jakabo27/Gesture-Controlled-Volleyball-Scoreboard/README.md

# Gesture-Controlled Volleyball Scoreboard

A portable, battery-powered LED scoreboard I designed and built from scratch, and taught to keep score by watching the players. A **Raspberry Pi 4** runs a pose-estimation neural network on a wide-angle camera at the net. When a player holds a **T-pose**, their team gets a point. Hands on top of the head (the "surrender cobra") takes the point back. An **Arduino Mega** owns the score, drives 252 addressable LEDs, plays voice clips from an SD card, and keeps working with its physical buttons whether or not the Pi is running.








<p align="center">
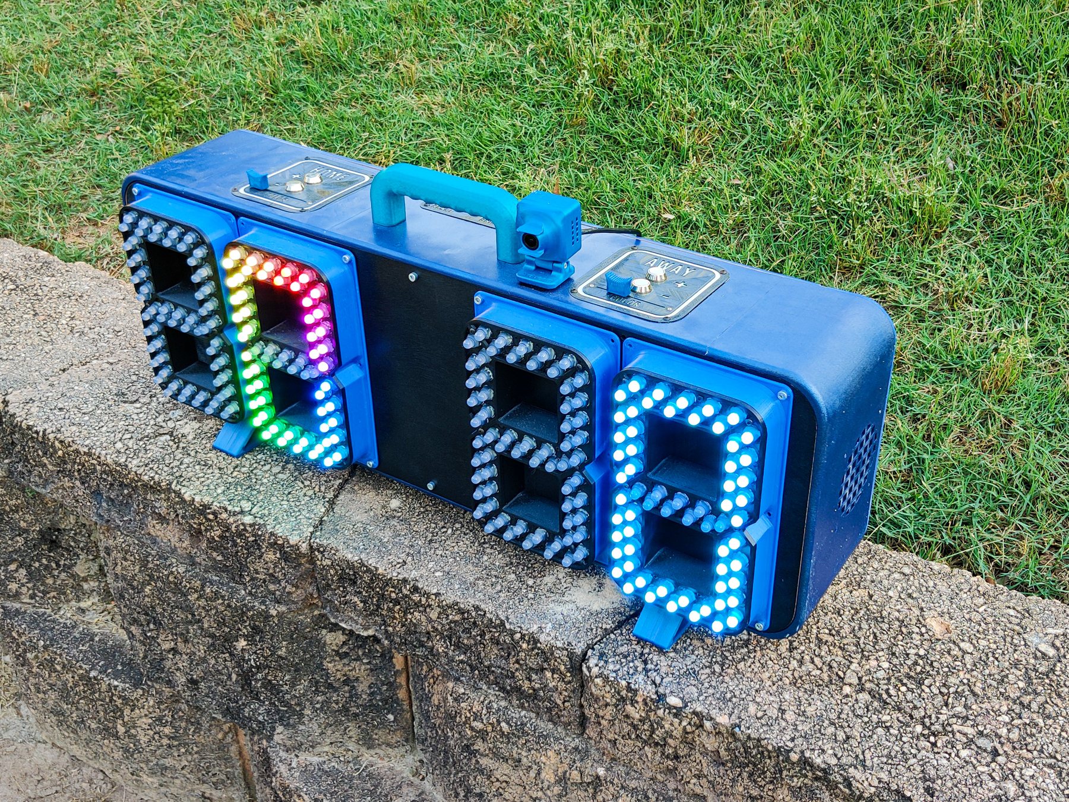
[picture p1: media/hardware/scoreboard-front.jpg]
The finished scoreboard sitting on a stone wall outdoors: a blue 3D-printed enclosure with a carry handle, four large seven-segment digits made of round LEDs (one lit in rainbow colors, one in blue), the camera on top, and the HOME and AWAY button panels on the top face
  
</p>

<!-- 🎬 HERO GIF: when media/video/tpose-scores-a-point.gif exists (see "Claude deleteme.md" → Shot list), uncomment the next line.
![A player holds a T-pose on the left side of the court; about half a second later the scoreboard's home score goes up by one and it announces the point](media/video/tpose-scores-a-point.gif)
-->

## Engineering skills on display

| Domain | What I built |
|---|---|
| **Edge ML & computer vision** | MoveNet MultiPose (TFLite, float16) on a Pi 4 CPU at ~2.9 fps. Two overlapping half-frame passes to track up to 12 players with a 6-person model, rule-based gesture recognition in pixel space, a live-fitted lens keystone model |
| **Embedded firmware** | Arduino Mega 2560 (C++): score and game logic, FastLED driving 252 WS2812B LEDs, 8-bit WAV playback from SD (TMRpcm), analog slide pots, I²C LCD, multi-button chords for menus, a checksummed serial protocol with the Pi (hello-gated, de-duplicated) |
| **Electrical & power** | Ryobi 18V tool-battery power, fused distribution, high-current 5V buck rail for the LEDs, Pi and Arduino, panel voltage and current meters, 3.3V→5V logic interfacing, a dozen hand-wired GPIO and data runs |
| **Mechanical & CAD** | Full enclosure designed in Fusion 360 and 3D-printed: segment carriers, battery dock, camera mount, vents and fan duct, service door, handle |
| **Linux reliability** | systemd service with watchdogs, camera hot-plug recovery, power-cut-safe file writes, boot-time tuning, remote deploys with automatic rollback |
| **Testing with real data** | Field-capture logging of every scored point, offline replay of saved keypoints to tune the rules, false-positive regression on recorded games, fault injection, soak testing |

## How it works

<picture>
  <source media="(prefers-color-scheme: dark)" srcset="media/diagrams/architecture-dark.svg">
  How it fits together. A wide-angle USB camera streams MJPG frames to a Raspberry Pi 4. The Pi runs MoveNet MultiPose on two overlapping half-frames, applies the T-pose and cobra gesture rules, and recovers on its own from faults. It talks to an Arduino Mega 2560 over a serial link: a hello every se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
</picture>

The split is deliberate. **The Arduino is in charge.** It holds the score, and the five physical buttons always work. The Pi only *suggests* points, over a serial link: it says hello every second while vision is live, and sends checksummed +1 / −1 messages for the camera's left (away) or right (home) half. The Arduino acts on them only while the hellos keep coming, and it announces when the Pi connects or drops out. If the camera fails, the Pi crashes, or it's simply left at home, the scoreboard is still a scoreboard.

1. **Camera:** a wide-angle USB camera sits low at the net post, looking along the net so it sees both teams. Frames arrive as hardware MJPG at 1280×720, read by a threaded grabber that always hands over the newest frame.
2. **Two passes:** each frame is split into a left half (the away team) and a right half (home) that overlap by 12% around the net line, and each half goes through MoveNet MultiPose separately.
3. **Rules:** every detected player is checked for a T-pose or a cobra in true pixel geometry. A T-pose has to appear in 2 of the last 3 frames, and a cobra has to be held for 0.8s.
4. **Point:** the Pi sends a checksummed message naming the camera half, three times with one id. The Arduino applies it once, adds the point, re-draws the digits and plays the point sound.

## The build

| | |
|:---:|:---:|
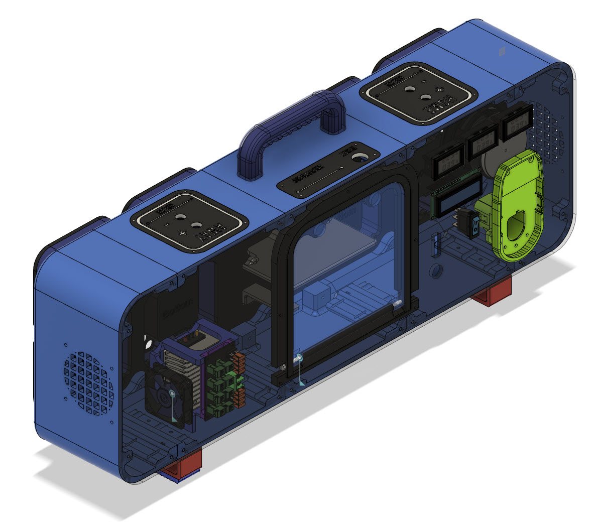
[picture p2: media/build/cad-render-fusion360.jpg]
Fusion 360 render of the enclosure with a transparent shell showing the Raspberry Pi, the battery dock and the internal layout
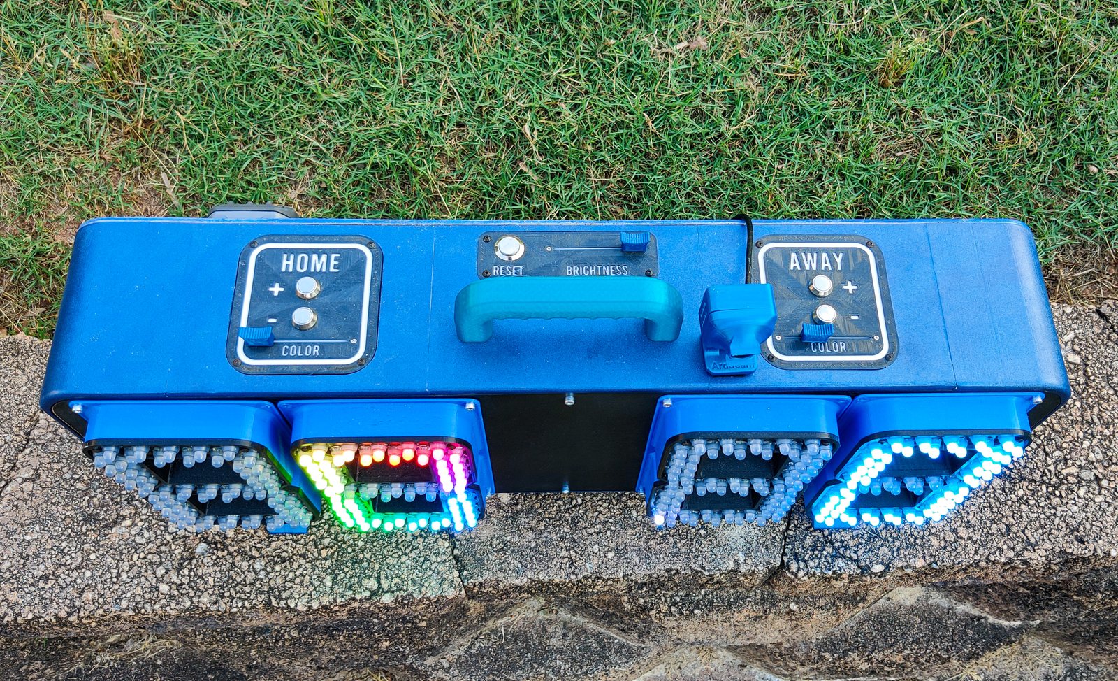
[picture p3: media/hardware/top-controls.jpg]
The top of the scoreboard: HOME and AWAY panels with plus, minus and color controls, the reset button and brightness slider in the middle, and the camera on its mount
|  |  |
| *Designed in Fusion 360 first: every internal part has a printed mount* | *Top controls: + / − per team, color sliders, reset and brightness* |
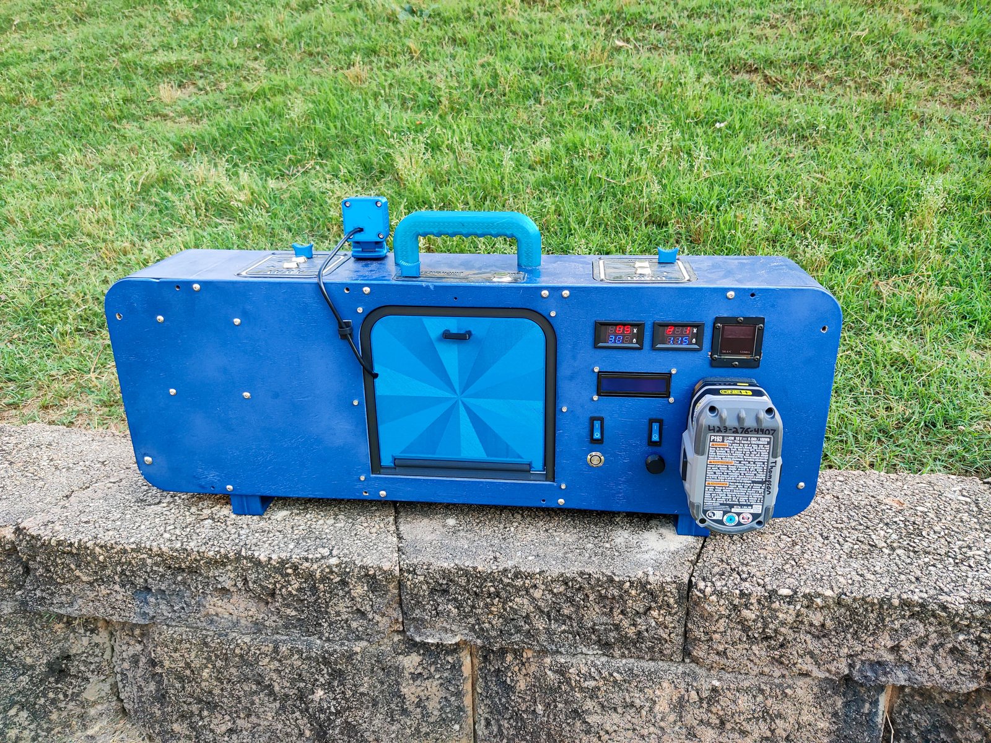
[picture p4: media/hardware/rear-panel.jpg]
The back of the scoreboard: a large speaker grille, two panel meters, the LCD, switches and the Ryobi 18V battery docked on the right
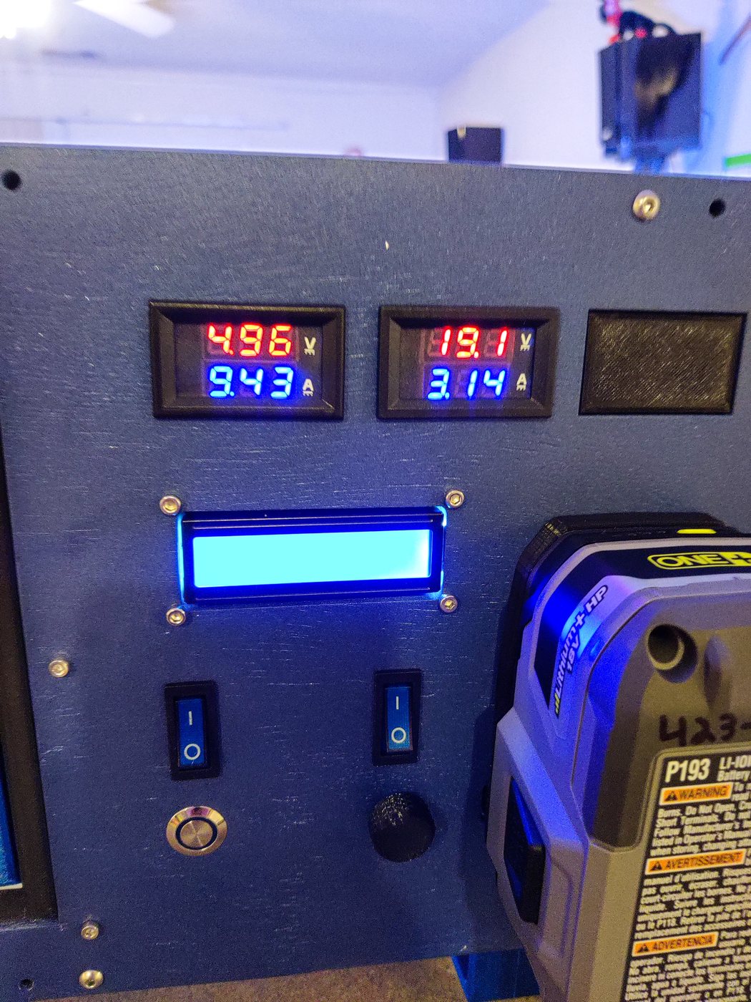
[picture p5: media/hardware/power-panel-closeup.jpg]
Close-up of the rear panel: two voltage and current meters reading 4.96V at 9.43A and 19.1V at 3.14A, a blue 16x2 LCD, two rocker switches, the power button and the Ryobi battery
|  |  |
| *Rear: speaker, power panel and a Ryobi 18V tool battery* | *Live meters for the 5V rail and the battery (here 9.4A at 5V with the LEDs lit)* |
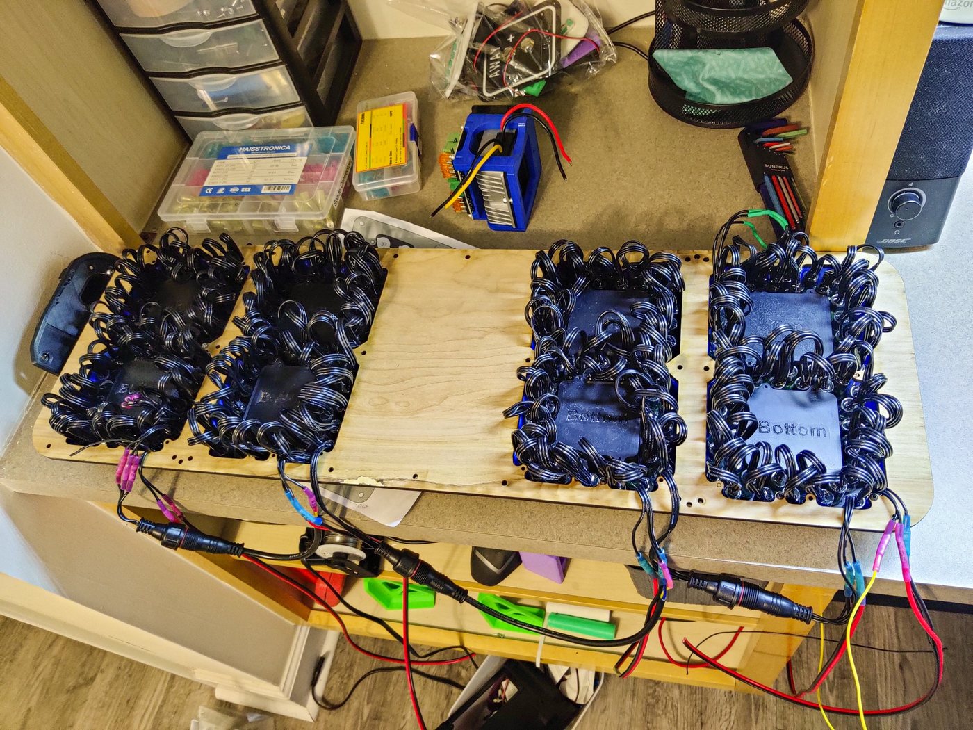
[picture p6: media/build/led-segment-build.jpg]
Four LED digit carriers on a workbench, each wound with strings of round WS2812B LEDs and wired to test leads
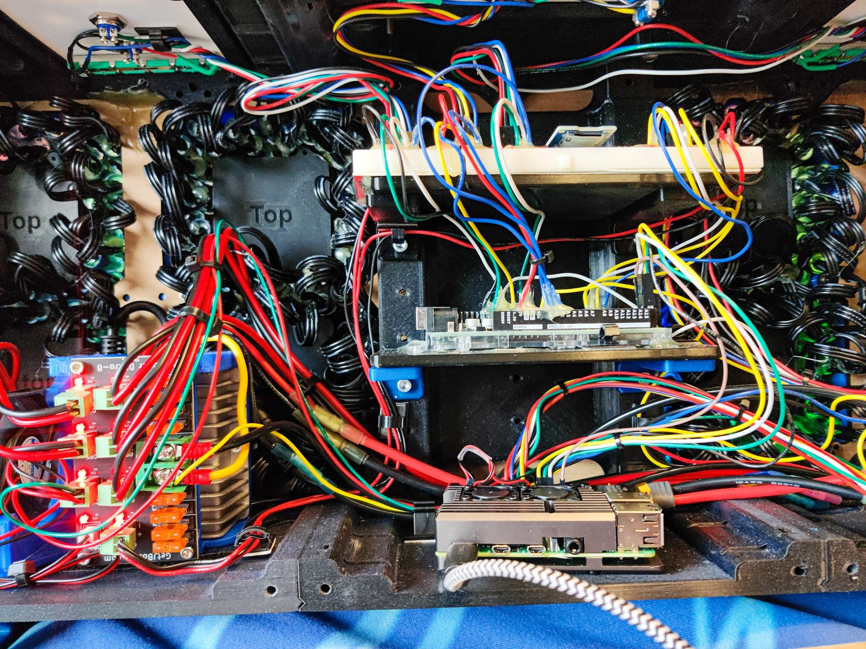
[picture p7: media/build/internal-wiring.jpg]
Inside the enclosure: the LED digit carriers on both sides, terminal blocks and distribution on the left, the Arduino Mega on a printed shelf, and the Raspberry Pi at the bottom
|  |  |
| *Each digit is 7 segments × 9 LEDs, strung by hand into printed carriers* | *Inside: power distribution (left), Arduino Mega (shelf) and the Pi (bottom)* |
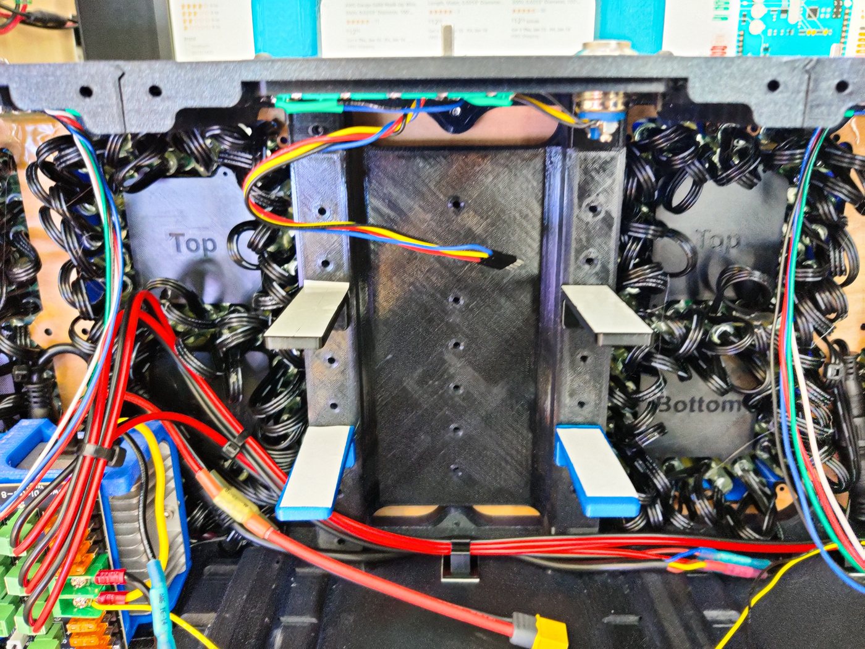
[picture p8: media/build/led-segment-wiring.jpg]
The back of the display during assembly: LED digit carriers labeled Top and Bottom, wired along a printed spine with data and power runs
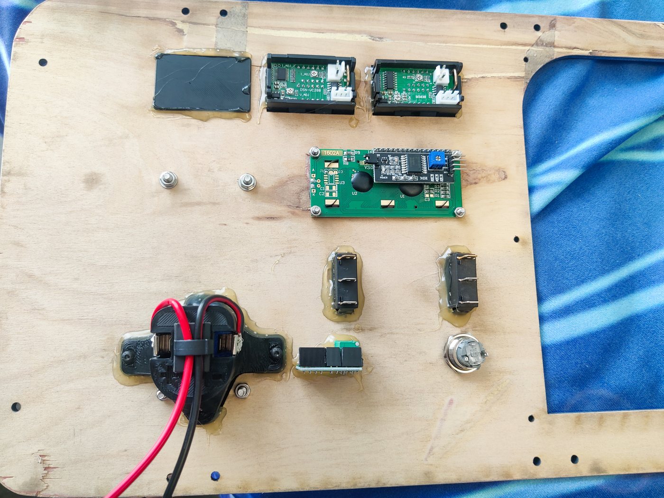
[picture p9: media/build/control-panel-prototype.jpg]
The rear control panel as a plywood prototype: two panel meters, the LCD, rocker switches, a power button and the battery connector, laid out before the final printed panel
|  |  |
| *Digit carriers going into the shell, data and power run along the spine* | *Rear panel laid out in plywood first, then printed* |
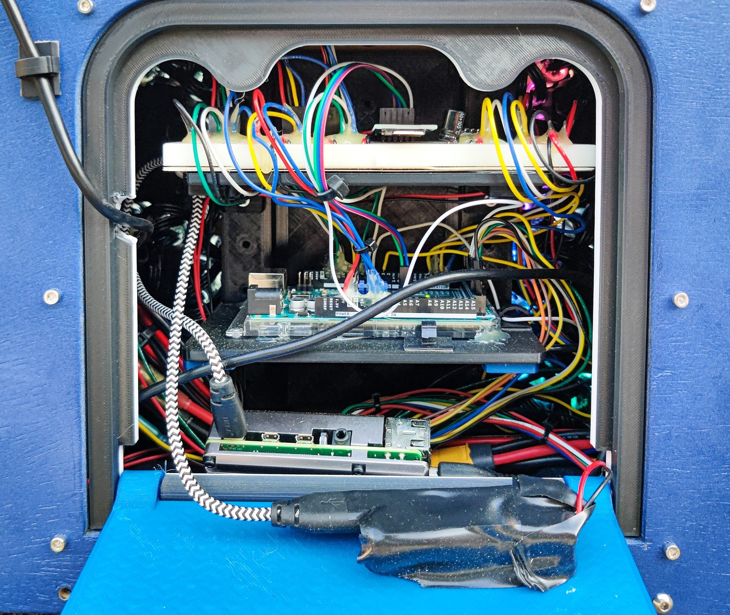
[picture p10: media/hardware/electronics-bay.jpg]
The electronics bay seen through the open service door: the Arduino Mega and wiring on a shelf above the Raspberry Pi
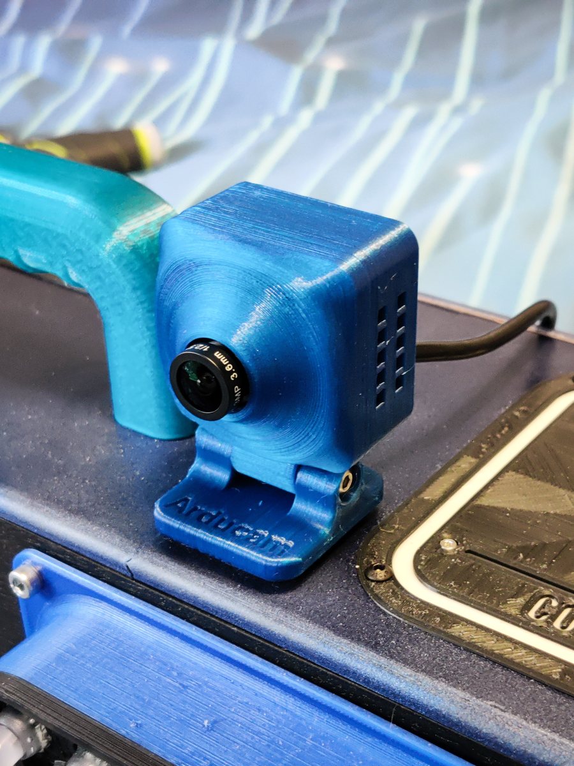
[picture p11: media/hardware/camera-mount.jpg]
The wide-angle USB camera in a blue 3D-printed housing on a hinged mount next to the handle
|  |  |
| *Service door open: everything stays reachable for repairs at the court* | *The camera in its printed, hinged housing* |

<!-- 📸 PHOTO SLOTS (see "Claude deleteme.md" → Shot list). Uncomment each row as the photo lands in media/.
| <img src="media/hardware/power-distribution.jpg" width="420" alt="The fuse block, 5V buck converter and XT60 battery input inside the enclosure"> | <img src="media/hardware/pi-arduino-harness.jpg" width="420" alt="The ribbon of GPIO wires between the Raspberry Pi header and the Arduino Mega's double-row header"> |
| *Power: battery input, fuses and the 5V buck converter* | *The Pi-to-Arduino signal harness* |
| <img src="media/hardware/oled-aim-assist.jpg" width="420" alt="The small OLED on the scoreboard showing the camera view with the yellow net line used to aim the camera"> | <img src="media/hardware/scoreboard-at-the-court.jpg" width="420" alt="The scoreboard set up at the net post during a game"> |
| *OLED aim assist: line the far net post up with the yellow line* | *At the court* |
-->

The enclosure is entirely 3D-printed. It has a carry handle, a hinged camera mount, vents and a cooling fan, a printed dock for a standard Ryobi 18V battery, and a service door. The power path runs from the battery through an XT60 connector and fuses to a high-current 5V buck converter. That one 5V rail feeds the LEDs (about 9.4A when bright), the Arduino and the Pi. Panel meters show the battery and the 5V rail live, which made checking the LED current budget easy in the field.

## What it does

- **Scores points from gestures:** T-pose for +1, the hands-on-head "surrender cobra" for −1 (to undo a mistake). Each team's side is decided by the player's **torso center**, so reaching over the net never scores for the other team.
- **Handles up to 12 players** (6v6) even though MoveNet MultiPose returns at most 6 people per image. [How →](#the-hard-parts)
- **Manual control always works:** + / − buttons per team, reset, brightness and per-team color sliders (including a rainbow mode). Button chords change settings: 2 buttons cycles game-to 21 / 25 / 15, 3 toggles voice or beeps, 4 switches between volleyball and **tennis scoring** (15 / 30 / 40, deuce and advantage spelled out on the 7-segment digits).
- **Talks:** voice clips for every point, undo, reset and mode change, a connect and disconnect announcement for the Pi, and a victory song when a team wins by 2.
- **Aims itself:** for the first 5 minutes after boot, a small OLED shows the camera view with the current net line, so the camera can be lined up with the far post.
- **Logs its own decisions:** every scored point saves the 20 frames before and 6 after with each player's skeleton and the exact rule values that passed or failed, so the rules can be tuned from real games.
- **Runs unattended:** it starts on power-up with no network, survives camera unplugs and power cuts, and shuts down cleanly from a held button.

## The hard parts

### 12 players from a 6-person model

MoveNet MultiPose returns at most **6 people** per image. A 6v6 game has 12 players, and a back-row player calling a point is exactly who a single pass drops. Each frame is split at the net line into two halves that **overlap by 12%**, and each half gets its own pass, so each team gets the model's full 6-person capacity. The overlap means an arm stretched across the net is never cropped off. Each pass then keeps only the people whose torso centroid is on its own side of the net line, so someone visible in both halves is checked exactly once, for the team they're standing with.

<p align="center">
  The camera view divided at the net line. The auto-calibrated net line is clamped to within 7% of center. A home player with their torso at x=0.41 reaches across the net line, and the point still goes to home.
</p>

The net line calibrates itself from the median positions of upright players on each side, smoothed over 30s windows, and is **hard-clamped to ±7%** of frame center so a timeout huddle on one side can't drag it away.

### A wide-angle camera sitting on the ground

The camera sits low and looks slightly up through a ~93° lens (measured with a checkerboard calibration). That breaks naive pose geometry in three ways, all found by replaying logged points frame by frame:

- **Keystone lean.** Upright people near the frame edges appear to lean outward, measured at about **−28° × (x − 0.5) + 2.4°**: roughly 10° at each edge. Real T-poses at the sideline failed the tilt check for 1.5s. A `KeystoneEstimator` re-fits that lean every 60s from upright people in view and subtracts it. It's only ever applied when it makes the check *more* lenient, so a bad fit can't block a real point.
- **Tilt-proof arm checks.** "Arms level" is measured along the player's own hip→shoulder axis instead of image vertical, and arms must be 90° ± 20° to the spine. That makes the check immune to a camera tilted on uneven sand.
- **Close players losing their heads.** Within ~2m of the camera, heads leave the frame and MoveNet mirrors left and right or loses a wrist. A T-pose is symmetric, so swapped labels are swapped back. One missing wrist is projected as a straight forearm from the elbow when the other arm is complete.

| | |
|:---:|:---:|
| The five T-pose rules: level arms within 0.35 shoulder widths, elbows at least 135 degrees, wingspan at least 1.85 shoulder widths, strict joint order, and held in 2 of the last 3 frames | Camera tilt on sand handled with spine-relative geometry, and wide-angle edge foreshortening handled by easing the wingspan requirement from 1.85 to 1.70 toward the frame edges |

**Result:** replaying 22 logged events, the new rules accepted **151 T-pose frames vs 80** before, losing none, and most points would have confirmed 2–3s sooner. Running the old and new rules on **392 recorded game frames** plus all indoor test footage, the new rules added 22 accepted frames and dropped none, and every added frame was a genuine T-pose.

**Drooping arms (Oct 5).** Real T-poses are often held with the arms a little below level. A second, relaxed tier accepts arms hanging up to 0.8 shoulder widths below the shoulders (never above level) but asks for a ~1 s hold instead of 2 of 3 frames. Replayed on the logged court frames it rescued a pose that had never scored, kept every point that scored before, and added no false positives. Details in [`docs/engineering-log.md`](docs/engineering-log.md) section 34.

<!-- 📸 DETECTION FRAME: a logged PoseEvent frame (skeleton, measured values, 2-of-3 window) belongs here. Candidates are in _private/candidate-media/.
<p align="center"><img src="media/screenshots/pose-event-trigger.jpg" width="720" alt="An annotated trigger frame: the player's skeleton drawn in green with the measured shoulder width, tilt, height offset, arm-to-spine angles and wingspan ratio, the yellow net line, and the 2-of-3 window state for each side"></p>
-->

### Running unattended on a battery at a beach

Nobody can SSH into it mid-game, so it has to recover from everything by itself:

- **Camera hot-plug.** The USB camera dropped off the bus several times during boot and once mid-game (USB `error -71`, with no undervoltage). The camera is now opened by its stable `/dev/v4l/by-id` path rather than `/dev/video0`, because it came back as `video1` and the old code kept retrying the wrong device. Bit-identical frames for 5s mean a hung camera, which gets re-opened. Frames older than 2s are refused, so a frozen image can never re-score. Verified with a software USB unbind and rebind: it recovers in about 12s.
- **Hello semantics.** A dedicated thread sends the serial hello every 1.0s, but only while the main loop is processing live frames, so "Pi connected" on the Arduino really means "vision is working".
- **Watchdogs.** If the main loop stops for 60s the process exits, and systemd restarts it. The camera thread catches any exception, releases the device and re-opens it.
- **Power cuts.** It gets switched off at the battery. Every capture is written to a `.tmp` file, `fsync`ed, then atomically renamed, and leftover temp files are cleaned at start-up. The Pi has no clock battery, so time jumps by hours once NTP syncs. All interval timing uses `time.monotonic()`, and capture files carry a session counter instead of trusting the wall clock.
- **Bounded everything.** There's a 5GB capture cap with oldest-first rotation (scored points are kept), a stop-writing threshold at 2GB free, and bounded queues. Memory stayed flat at about 203MB over long runs.
- **Boot.** Live detection starts about 14s after the kernel starts. The service no longer waits for the network, Bluetooth initialization is disabled, and cold imports are the remaining cost.

### An embedded bug worth remembering

The Arduino decides whether the Pi is alive by comparing heartbeat periods: `this < prev + range && this > prev - range`. An intermediate firmware made those periods `unsigned long`. With a 1s heartbeat and a 700ms range, `prev - range` is fine, but for any period under 700ms it **wraps to about 4.29 billion**, so no period ever matched. The Pi was declared disconnected about 7s after every connect. The fix is signed 32-bit `long` periods, plus a debounce of 3 consecutive irregular beats before declaring a disconnect, and an instant first connect on boot.

The heartbeat wire has since been retired altogether. While the Pi boots or shuts down it pulls GPIO 0–8 high for about 17s, and the Arduino counted the "home" line sitting high as a point every 3s. Rather than keep patching pulse timing, every Pi → Arduino signal now travels over the serial link that was added for the phone display: a hello is the heartbeat, and each gesture is a checksummed message sent three times with one id, so a copy lost while the LEDs refresh (interrupts off for ~8ms) doesn't matter and a duplicate is never counted twice.

## Measured

| | Result |
|---|---|
| Vision loop (two MoveNet passes + rules) | **~340ms per frame (~2.9 fps)** on a Pi 4, 3 inference threads |
| Hold-to-point latency | 2 of 3 frames ≈ **0.3–0.6s** once the pose is held |
| Players tracked | up to **12** (6 per half) |
| Boot to live detection | **~14s** after kernel start |
| Camera USB drop-out → frames again | **~12s**, automatic |
| Memory over a long run | flat at **~203MB** RSS |
| Rule rework on 22 logged events | **151 vs 80** accepted frames, 0 lost |
| False-positive check (392 game frames + indoor footage) | 0 accepted frames lost, 22 added, all genuine |

## Wiring

<p align="center">
  Wiring diagram: the serial link (Pi GPIO 0 and 1 to Mega pins 15 and 14, through a 1k resistor and a 5.1k/10k divider) carries every signal; the older GPIO wires (Pi GPIO 5, 6, 19, 21, 26 and 13 to Mega pins 45, 47, 43, 42, 46 and 44) are legacy; plus physical pin locator maps for both boards
</p>

| Signal | Pi pin (BCM) | Mega pin | Notes |
|---|---|---|---|
| **Serial: Pi → Arduino** (pink) | 27 (GPIO 0, TXD2) | 15 (RX3) | via 1k. Hello every 1s, gestures (+1 / −1), phone commands |
| **Serial: Arduino → Pi** (pink) | 28 (GPIO 1, RXD2) | 14 (TX3) | via a 5.1k/10k divider (the Mega TX is 5V). Score state for the phone |
| Ground | 39 | GND | common ground is mandatory |
| Home +1 (camera right), legacy | 29 (GPIO 5) | 45 | held low; only read for an older engine (hello version 1) |
| Away +1 (camera left), legacy | 31 (GPIO 6) | 47 | same |
| Away −1 (camera left), legacy | 35 (GPIO 19) | 43 | same |
| Home −1 (camera right), legacy | 40 (GPIO 21) | 42 | same; no signal reaches pin 42 (measured) |
| Heartbeat, legacy | 37 (GPIO 26) | 46 | ignored: the serial hello is the heartbeat |
| Spare | 33 (GPIO 13) | 44 | unused |

The GPIO wires stay connected but are no longer used. The pin pairs above are as measured on the bench in October 2026; the original wiring notes had each pair crossed.

The Pi's 3.3V outputs drive the Mega's 5V inputs directly: 3.3V clears the ATmega2560's 3.0V input-high threshold, and nothing ever drives 5V back into the Pi. Locally on the Pi there's also an SSD1351 RGB OLED on SPI and a power button (hold 5s to shut down). Full details are in [`pi/README.md`](pi/README.md) and [`arduino/README.md`](arduino/README.md). To set up a Pi from a blank SD card (including how everything starts on boot), see [`docs/pi-setup-from-scratch.md`](docs/pi-setup-from-scratch.md).

## The score on my phone

A phone page shows the live score in huge digits, runs the game clock, and has +1 / −1 buttons and settings, **over Bluetooth LE with no Wi-Fi** (there usually isn't any at the courts).

<p align="center">
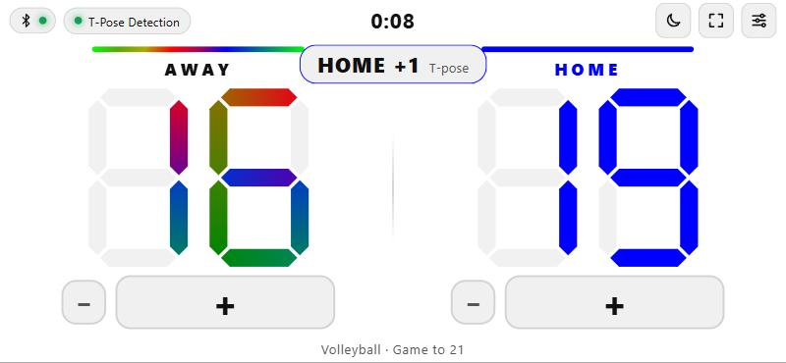
[picture p12: media/screenshots/phone-display-landscape.jpg]
The phone page in landscape: a Bluetooth status icon, a T-Pose Detection switch and a game clock along the top, away and home scores in large seven-segment digits in the team colors, and a large plus and a small minus button under each team
  
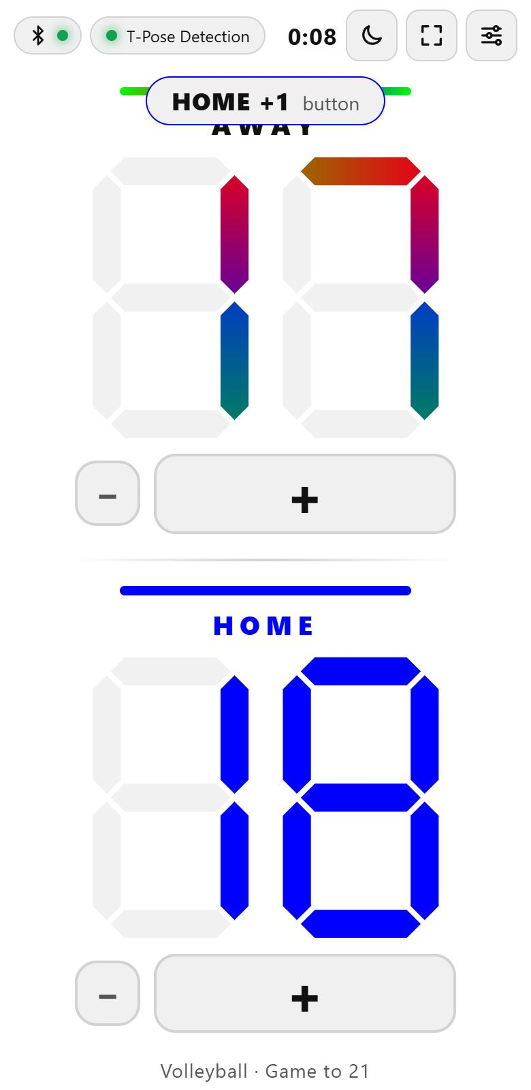
[picture p13: media/screenshots/phone-display-portrait.jpg]
The same page in portrait with the two teams stacked
  
</p>

* The **Arduino stays the source of truth** and only broadcasts its state over a one-way serial link (Mega TX3 → Pi UART2, through a 5.1k/10k divider), so the scoreboard works exactly as before with no Pi or phone.
* A small **Pi service** turns that into a Bluetooth LE GATT service (BlueZ over D-Bus) and forwards a whitelist of phone commands back: score +/−, sport, game-to, and the sound mode.
* The **page** is a dependency-free Web Bluetooth app on GitHub Pages, installable and cached for offline use. It copies the LED colors exactly (including the strip's swapped red/green), and a **T-Pose Detection** switch can turn off the Pi's gesture scoring from the phone if false positives show up in a game.
* Connections are manual, the Pi never pairs, and a phone must say "hello" within a few seconds or it's disconnected, so other Bluetooth apps in the stands can't take over the scoreboard.
* Android with Chrome is the reliable path. iPhones need the Bluefy app (Safari has no Web Bluetooth), and the Pi's Bluetooth stack was upgraded to BlueZ 5.79 to survive them.

Wiring, protocol, deployment and the lessons learned (like why the LEDs must not refresh while a sound clip plays) are in [`docs/phone-display.md`](docs/phone-display.md); the page's own notes are in [`web/`](web/).

## Repository layout

| Folder | What's in it |
|---|---|
| [`pi/`](pi/) | The vision engine as deployed: `PoseEstimationJT_Optimized.py`, the OLED helper, the TFLite model, the systemd unit and a `/boot/config.txt` snapshot |
| [`arduino/`](arduino/) | The Mega 2560 scoreboard firmware |
| [`legacy/`](legacy/) | The original 2022 Pi script, kept for comparison |
| [`web/`](web/) | The phone display: a Web Bluetooth page (live score, game clock, +/− buttons, settings, day and night themes) |
| [`tests/`](tests/) | Wire-contract tests that keep the Arduino line format, the Pi's BLE packet and the page's decoder in sync |
| [`docs/`](docs/) | The engineering log (every measurement and decision, in order) and the [phone display write-up](docs/phone-display.md) |
| [`tools/`](tools/) | `clean_wavs.py` (de-hiss, trim and normalize the SD-card voice clips) and the source for the architecture diagram |
| `media/` | Photos, diagrams, screenshots |

## History

Version 1 was built over the 2021–22 winter: the enclosure, the LED digits, the Arduino firmware, and a first Pi script that checked the left half of the court, then the right half only if the left had no T-pose (one MoveNet pass each, so at most 6 people per side, and no recovery from crashes). In 2026 I rebuilt the vision side for real games: 12-player coverage, the wide-angle geometry fixes, the reliability work, field logging and boot tuning. The 2022 script is in [`legacy/`](legacy/) for comparison.

## License

MIT. See [`LICENSE`](LICENSE). The MoveNet model is Apache 2.0 (see [`pi/README.md`](pi/README.md)).
