jakabo27/Gesture-Controlled-Volleyball-Scoreboard/tests/fixtures/pole_early.jpg

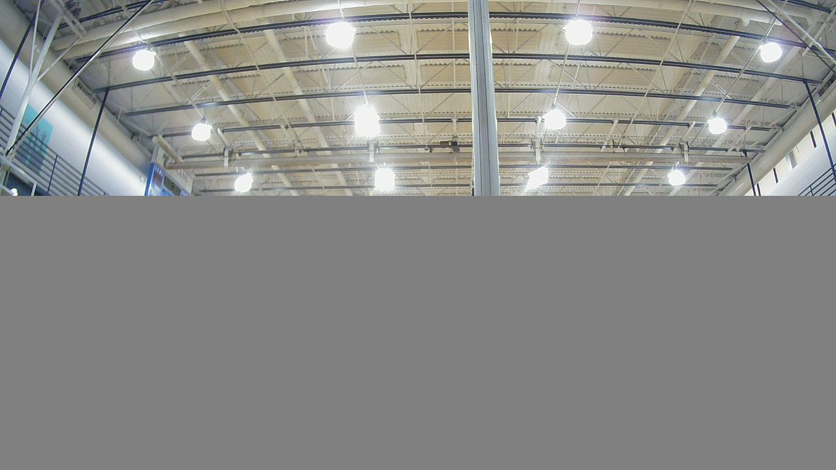
tests/fixtures/pole_early.jpg
