jakabo27/Gesture-Controlled-Volleyball-Scoreboard/tests/fixtures/pole_late.jpg

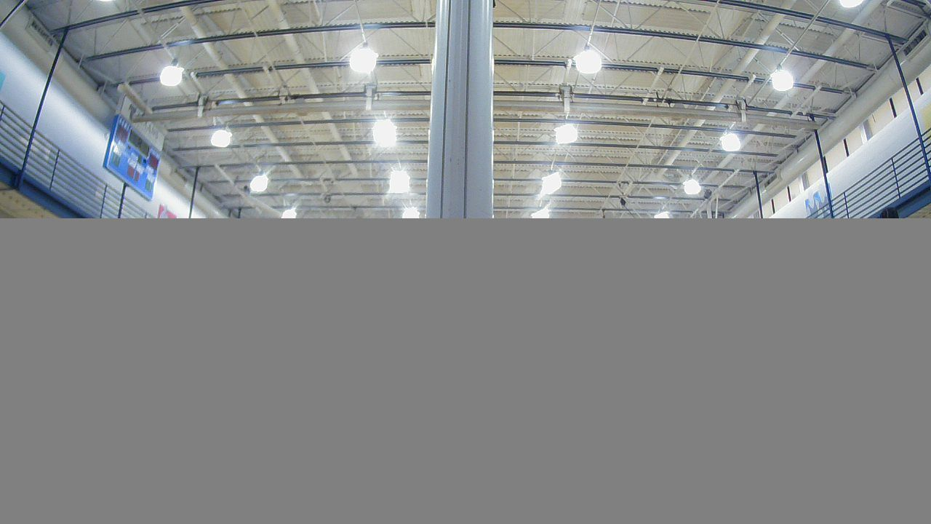
tests/fixtures/pole_late.jpg
