jakabo27/Gesture-Controlled-Volleyball-Scoreboard/tests/test_tpose_rules.py

"""
Rule tests for the T-pose check and its two-tier confirmation in pi/PoseEstimationJT_Optimized.py. Needs numpy.
Run from the repo root:

    python tests/test_tpose_rules.py

The engine imports the camera, TFLite and GPIO libraries, so the functions under test are pulled out of its source
with ast and run in a small namespace (same idea as the sketch checks in test_link_protocol.py).

The skeletons are synthetic: shoulders 80 px apart, arms 120 px long (1.5 shoulder widths), hanging `drop_deg` below
level (negative = raised). Numbers below were checked against real court frames in docs/engineering-log.md section 34.
"""
import ast
import math
import os
import sys
import unittest

import numpy as np

ROOT = os.path.dirname(os.path.dirname(os.path.abspath(__file__)))
ENGINE = os.path.join(ROOT, 'pi', 'PoseEstimationJT_Optimized.py')

NEEDED_FUNCS = {'calculate_angle_px', 'check_t_pose', 'tpose_confirmed', 'people_present', 'read_strictness'}
NEEDED_CONSTS = {'LIMB_CONF_THRESH', 'CLOSE_RANGE_SHOULDER_PX', 'CLOSE_RANGE_TOP_FRACTION', 'MIN_TPOSE_SHOULDER_PX', 'KP',
                 'POSE_HOLD_FRAMES', 'POSE_WINDOW_FRAMES', 'STRICTNESS_FILE', 'DEFAULT_STRICTNESS', 'STRICTNESS_PRESETS',
                 'STRICTNESS_WINDOW_MAX', 'SAVE_MIN_SHOULDER_PX', '_strictness_cache'}


def load_engine():
    src = open(ENGINE, encoding='utf-8').read()
    chunks = []
    for node in ast.parse(src).body:
        if isinstance(node, ast.FunctionDef) and node.name in NEEDED_FUNCS:
            chunks.append(ast.get_source_segment(src, node))
        elif isinstance(node, ast.Assign) and any(isinstance(t, ast.Name) and t.id in NEEDED_CONSTS for t in node.targets):
            chunks.append(ast.get_source_segment(src, node))
    ns = {'np': np, 'os': os}
    exec('\n\n'.join(chunks), ns)
    return ns


E = load_engine()
KP = E['KP']
FRAME_H = 648


def person(drop_deg=0.0, elbow_bend_deg=0.0, shoulder_w=80.0, arm_len=120.0, cx=640.0, conf=0.9):
    """Front-facing person, arms out to the sides, hanging drop_deg below level (negative = raised)."""
    k = np.zeros((17, 3), dtype=np.float32)
    k[:, 2] = conf
    half = shoulder_w / 2.0
    sy, hy = 300.0, 420.0
    k[KP['left_shoulder']][:2] = (cx + half, sy)          # the person's left = image right (no label swap needed)
    k[KP['right_shoulder']][:2] = (cx - half, sy)
    k[KP['left_hip']][:2] = (cx + half * 0.7, hy)
    k[KP['right_hip']][:2] = (cx - half * 0.7, hy)
    t = math.radians(drop_deg)
    bend = math.radians(elbow_bend_deg)
    for side, sh_name, el_name, wr_name in ((1.0, 'left_shoulder', 'left_elbow', 'left_wrist'),
                                            (-1.0, 'right_shoulder', 'right_elbow', 'right_wrist')):
        sx, sy_ = k[KP[sh_name]][:2]
        ex, ey = sx + side * 0.55 * arm_len * math.cos(t), sy_ + 0.55 * arm_len * math.sin(t)
        k[KP[el_name]][:2] = (ex, ey)
        # forearm continues the upper arm, optionally bent upwards by elbow_bend_deg
        ft = t - bend
        k[KP[wr_name]][:2] = (ex + side * 0.45 * arm_len * math.cos(ft), ey + 0.45 * arm_len * math.sin(ft))
    return k


def check(k, preset=None):
    diag = {}
    limits = E['STRICTNESS_PRESETS'][preset] if preset is not None else None     # None = the default (Standard)
    ok = E['check_t_pose'](k, player_global_x=0.5, expected_lean_deg=0.0, frame_h=FRAME_H, diag=diag, limits=limits)
    return ok, diag['fails'], diag['metrics']


class TPoseRuleTest(unittest.TestCase):
    def test_level_arms_pass_the_strict_tier(self):
        ok, fails, m = check(person(0))
        self.assertTrue(ok, fails)
        self.assertFalse(m['relaxed_only'])

    def test_slightly_raised_arms_still_pass_strict(self):
        ok, fails, m = check(person(-10))
        self.assertTrue(ok, fails)
        self.assertFalse(m['relaxed_only'])

    def test_drooping_arms_pass_only_the_relaxed_tier(self):
        for drop in (15, 25):
            ok, fails, m = check(person(drop))
            self.assertTrue(ok, 'droop %d: %s' % (drop, fails))
            self.assertTrue(m['relaxed_only'], 'droop %d should need the longer hold' % drop)

    def test_arms_hanging_far_below_level_fail(self):
        ok, fails, _ = check(person(40))
        self.assertFalse(ok)
        self.assertIn('height_align', fails)

    def test_raised_arms_are_not_relaxed(self):
        # the relaxation is one-sided: hanging low is tolerated, rising above level is not
        for rise in (-15, -25):
            ok, fails, _ = check(person(rise))
            self.assertFalse(ok, 'arms %d deg above level must still fail' % -rise)
            self.assertIn('height_align', fails)

    def test_bent_elbows_fail(self):
        ok, fails, _ = check(person(0, elbow_bend_deg=70))
        self.assertFalse(ok)
        self.assertIn('elbow_straight', fails)

    def test_arms_down_fail(self):
        ok, _, _ = check(person(80))
        self.assertFalse(ok)

    def test_far_player_tolerance_floor(self):
        # small player (40 px shoulders): the 14 px floor applies, a clean T-pose still passes
        ok, fails, _ = check(person(0, shoulder_w=40.0, arm_len=60.0))
        self.assertTrue(ok, fails)


class StrictnessPresetTest(unittest.TestCase):
    """The phone's Detection strictness: 0 Stricter, 1 Standard (default), 2 Looser, 3 Loosest. Each step lets arms hang a
    little lower, down to about 45 degrees away from the side of the body for Loosest; arms ABOVE level are never relaxed.
    (Skeleton: shoulders 80 px, arms 120 px, so the allowed drop is 0.65 / 0.8 / 0.9 / 1.0 shoulder widths = 52 / 64 / 72 /
    80 px against 120 * sin(drop_deg); the spine angle limits are 125 / 130 / 130 / 135 deg = 35 / 40 / 40 / 45 deg below level.)"""

    def passes(self, drop, preset):
        return check(person(drop), preset)[0]

    def test_four_presets_in_order(self):
        names = [p['name'] for p in E['STRICTNESS_PRESETS']]
        self.assertEqual(names, ['Stricter', 'Standard', 'Looser', 'Loosest'])
        self.assertEqual(E['DEFAULT_STRICTNESS'], 1)
        below = [p['below_k'] for p in E['STRICTNESS_PRESETS']]
        spine = [p['spine_max'] for p in E['STRICTNESS_PRESETS']]
        self.assertEqual(below, sorted(below))
        self.assertEqual(spine, sorted(spine))

    def test_default_limits_are_standard(self):
        for drop in (0, 15, 30, 35, 40, 55):
            self.assertEqual(check(person(drop))[0], check(person(drop), 1)[0], drop)

    def test_each_step_accepts_lower_arms(self):
        expect = {                 # drop_deg: (stricter, standard, looser, loosest)
            15: (True, True, True, True),
            30: (False, True, True, True),
            35: (False, False, True, True),
            40: (False, False, False, True),
            45: (False, False, False, False),    # 120 * sin(45) = 85 px > the loosest 80 px drop: just past the loosest limit
            60: (False, False, False, False),
        }
        for drop, row in expect.items():
            self.assertEqual(tuple(self.passes(drop, i) for i in range(4)), row, 'drop %d' % drop)

    def test_raised_arms_fail_at_every_strictness(self):
        for preset in range(4):
            for rise in (-15, -25, -40):
                self.assertFalse(check(person(rise), preset)[0], 'preset %d, arms %d deg above level' % (preset, -rise))

    def test_clean_t_pose_passes_everywhere_as_strict(self):
        for preset in range(4):
            ok, fails, m = check(person(0), preset)
            self.assertTrue(ok, fails)
            self.assertFalse(m['relaxed_only'])

    def test_every_preset_holds_the_same_3_of_4(self):
        for p in E['STRICTNESS_PRESETS']:
            self.assertEqual((p['hold'], p['window']), (3, 4), p['name'])
            self.assertFalse(E['tpose_confirmed']([0, 1, 1, 0], p['hold'], p['window']), p['name'])   # two relaxed frames
            self.assertTrue(E['tpose_confirmed']([0, 1, 1, 1], p['hold'], p['window']), p['name'])    # three of four
            self.assertTrue(E['tpose_confirmed']([1, 1, 0, 1], p['hold'], p['window']), p['name'])

    def test_history_is_long_enough_for_every_preset(self):
        self.assertEqual(E['STRICTNESS_WINDOW_MAX'], max(p['window'] for p in E['STRICTNESS_PRESETS']))


class StrictnessFileTest(unittest.TestCase):
    """read_strictness: the engine re-reads the phone's choice about once a second; anything odd means Standard."""

    def setUp(self):
        import tempfile
        self.dir = tempfile.mkdtemp()
        self.path = os.path.join(self.dir, 'strictness.txt')
        E['STRICTNESS_FILE'] = self.path
        E['_strictness_cache']['t'] = -1e9

    def read(self, now):
        return E['read_strictness'](now)

    def test_missing_file_is_standard(self):
        self.assertEqual(self.read(1000.0), E['DEFAULT_STRICTNESS'])

    def test_values_are_picked_up_after_a_second(self):
        for i, v in enumerate((0, 2, 3)):
            open(self.path, 'w').write('%d\n' % v)
            self.assertEqual(self.read(2000.0 + 10 * i), v)

    def test_cached_within_a_second(self):
        open(self.path, 'w').write('3\n')
        self.assertEqual(self.read(3000.0), 3)
        open(self.path, 'w').write('0\n')
        self.assertEqual(self.read(3000.5), 3)       # not re-read yet
        self.assertEqual(self.read(3001.5), 0)

    def test_junk_is_standard(self):
        for i, junk in enumerate(('', 'abc', '7', '-1', '1.5')):
            open(self.path, 'w').write(junk)
            self.assertEqual(self.read(4000.0 + 10 * i), E['DEFAULT_STRICTNESS'], repr(junk))


class ConfirmationTest(unittest.TestCase):
    """window values: 0 = no T-pose, 1 = relaxed-only pass, 2 = strict pass; newest last"""

    def test_strict_needs_two_of_the_last_three(self):
        c = E['tpose_confirmed']
        self.assertTrue(c([0, 2, 0, 2]))
        self.assertTrue(c([2, 2]))
        self.assertFalse(c([0, 0, 2, 0]))
        self.assertFalse(c([2, 0, 0, 2]))          # the first hit fell out of the 3-frame window

    def test_relaxed_needs_three_of_the_last_four(self):
        c = E['tpose_confirmed']
        self.assertFalse(c([0, 1, 1, 0]))          # two relaxed frames are not enough
        self.assertTrue(c([1, 1, 0, 1]))
        self.assertTrue(c([0, 1, 1, 1]))

    def test_mixed_tiers_count_towards_the_relaxed_rule(self):
        self.assertTrue(E['tpose_confirmed']([2, 0, 1, 1]))


class PeriodicSaveGateTest(unittest.TestCase):
    """Periodic images are only saved while someone is in view (people_present)."""

    @staticmethod
    def entry(k):
        return {'kps': k.tolist()}

    def test_nobody_in_view(self):
        self.assertFalse(E['people_present']([]))

    def test_a_person_with_shoulders_found(self):
        self.assertTrue(E['people_present']([self.entry(person(0))]))

    def test_unsure_shoulders_do_not_count(self):
        k = person(0)
        k[KP['left_shoulder']][2] = 0.10
        self.assertFalse(E['people_present']([self.entry(k)]))

    def test_a_speck_does_not_count(self):
        # shoulders 8 px apart: a detection too small to be a person worth recording
        self.assertFalse(E['people_present']([self.entry(person(0, shoulder_w=8.0, arm_len=12.0))]))

    def test_one_real_person_among_specks(self):
        specks = [self.entry(person(0, shoulder_w=6.0, arm_len=9.0)) for _ in range(3)]
        self.assertTrue(E['people_present'](specks + [self.entry(person(0, shoulder_w=40.0, arm_len=60.0))]))


if __name__ == '__main__':
    unittest.main(verbosity=2)
