jakabo27/Gesture-Controlled-Volleyball-Scoreboard/(commit log)

2026-10-01 Gesture-controlled volleyball scoreboard: Pi vision engine, Arduino firmware, docs
    Snapshot of the known-good deployed state before the Bluetooth phone-display work:
    - pi/: vision engine as deployed (MoveNet MultiPose, two-pass 12-player coverage,
    T-pose/cobra rules, watchdogs), OLED helper, model, systemd unit + drop-in,
    /boot/config.txt snapshot
    - arduino/: Mega 2560 scoreboard firmware (signed heartbeat periods, debounce)
    - legacy/: the original 2022 Pi script for comparison
    - docs/: engineering log and the BLE phone-display plan
    - media/: build photos (metadata stripped), updated diagrams, architecture diagram
    [boot-config.txt]
2026-10-02 Phone display: Arduino state broadcast, Pi BLE link service, Web Bluetooth page
    - Arduino: one-way checksummed state line on Serial1 (38400) with scores, mode,
    game-to, Pi status, team colors (hue/white/rainbow), the drawn glyphs and the
    last event. Never blocks: written only when the TX buffer has room.
    - Pi: scoreboard_link.py reads UART2 (/dev/ttyAMA1) and serves a 17-byte BLE
    GATT characteristic via BlueZ D-Bus (no pip installs); systemd units incl. a
    timer that starts Bluetooth 20 s after boot.
    - web/: bold seven-segment display with FastLED-accurate team colors, day
    (sunlight) and night themes, colored-background option, mirrored layout for a
    phone behind the scoreboard wit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
2026-10-02 Docs: pink phone-link wiring, corrected Pi header map, from-scratch Pi setup
    - wiring-pi-to-arduino.svg: the two UART wires (Mega 18 TX1 -> divider -> Pi 28,
    Pi 27 -> 1k -> Mega 19 RX1) in bright pink in the schematic and on the physical
    maps; Pi 40-pin header redrawn with all 20 rows (the old drawing was a row short)
    and every pin numbered; Mega communication header (14-21) added; divider sketch
    and the config.txt line.
    - docs/pi-setup-from-scratch.md: OS, config.txt, packages, groups, every systemd
    unit and the boot chain, for rebuilding on a new Pi or a V2 board.
    - Engineering log section 30 (phone display), README wiring table rows.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
2026-10-02 Button chords on press, non-blocking celebration, phone sport/game-to, louder clips
    - Arduino: chords (2 = game-to, 3 = voice/beeps, 4 = sport) fire while held and
    announce immediately; the first button's point is undone; nothing triggers on
    release. Sport change re-arms the celebration. Victory song / melodies are
    non-blocking and any button press stops them. Serial1 RX accepts checksummed
    $C,MODE / $C,TO commands. BRIDGED_AUDIO option (inverted output on pin 2).
    - Pi: BLE command characteristic forwards only MODE,0|1 and TO,15|21|25.
    - Page: Settings > Scoreboard: sport and game-to, reflecting the board's state.
    - tools/clean_wavs.py --loud: look-ahead compression, +2 to +6 dB on s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
    [ScoreboardVolleyballChangeWinning.ino, scoreboard_link.py, test_link_protocol.py]
2026-10-02 Audible beeps: release Timer3 from pin 5 before tone(), raise beep pitch (BEEP_PITCH)
    TMRpcm leaves OC3A connected after a WAV ends, so tone() could not drive the
    speaker pin; beeps were also 50-100 Hz, below what the speaker reproduces.
2026-10-04 Move the Pi link to Mega Serial3 (pins 14/15), add LINK_DEBUG output, 5.1k/10k divider
    Pins 18/19 (Serial1) are wired to an unused level shifter, so the phone link
    uses Serial3 (TX3 = 14, RX3 = 15). The state line, command reader and docs are
    updated. LINK_DEBUG prints TX lines, RX results and 5 s stats on USB serial,
    only when the USB TX buffer has room.
2026-10-04 Fix BLE GATT registration (Service must be an ObjectPath) and unblock rfkill before starting Bluetooth
    Verified on the Pi with the Mega on Serial3: state lines arrive on /dev/ttyAMA1, Pi commands are accepted by the Mega, GATT service registered and advertising.
    [scoreboard_link.py]
2026-10-04 Phone page: LED red/green swap, game clock, 'Camera scoring' label, write-without-response settings
    The WS2812B strip is GRB but the sketch declares NEOPIXEL (RGB), so the LEDs show red and green swapped; the page now copies what the LEDs show. Game clock starts at the first point after 0-0, freezes on a win and resets at 0-0. The Pi offers write-without-response so settings no longer show 'GATT Error unknown'.
    [scoreboard_link.py]
2026-10-04 T-Pose Detection switch, phone score buttons, Bluetooth icon, sound modes, sticky Done
    - T-Pose Detection toggle on the phone: the Pi's link service sets /dev/shm/scoreboard_tpose_disabled and the vision engine skips its score pulses while it exists (detection, logging and captures continue). Always on after boot.
    - Phone + / - score buttons via SCORE,HU|HD|AU|AD; the sketch's button code is now shared functions.
    - Sound mode 0/1/2 (effects, 'Point home/away' voice, tones): 3-button chord cycles it, SOUND,0|1|2 sets it from the phone; reported in the state line and BLE flags.
    - Bluetooth status is an icon + dot with a tap tooltip; Settings has a sticky Done button; narrow-screen clock layout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
    [PoseEstimationJT_Optimized.py, ScoreboardVolleyballChangeWinning.ino, scoreboard_link.py, test_link_protocol.py]
2026-10-04 Auto-disconnect phones that aren't the page (HELLO handshake), sound-mode feedback sounds, Bluefy fixes
    - Pi: a phone must write HELLO,<token> within 8 s of connecting or it is disconnected; commands from phones that haven't said hello are refused.
    - Page: says hello after connecting (and every 30 s), polls/re-subscribes when notifications go quiet (Bluefy), hides the fullscreen button on iOS, 'Open in Bluefy' link.
    - Sketch: choosing Effects plays an effect (hUp1), Voice plays WavMd ('I am a talking scoreboard'), Tones plays the away-point tone.
    [ScoreboardVolleyballChangeWinning.ino, scoreboard_link.py]
2026-10-04 Page: poll 4x/s when Bluetooth notifications go quiet (Bluefy), show the fullscreen button on iOS again
2026-10-05 Pi: build BlueZ 5.79 from source and switch bluetoothd to it (drop-in), document it
2026-10-05 Scoreboard-owned game clock, toast fits narrow screens, 'Game to', Connecting feedback, no LED refresh while a clip plays
    - The Arduino now keeps the game clock (first point after 0-0, frozen on a win, reset at 0-0) and sends it in the state line; the Pi packs it into a 19-byte BLE packet. Phones no longer keep their own clock, so switching phones and Reset behave.
    - Page: toast wraps on narrow screens, 'Game to', 'Connecting...' state on the Connect button, fullscreen button hidden on iOS (use Bluefy's own).
    - Sketch: skip the ~8 ms FastLED refresh for the heartbeat dot while a WAV is playing (it made 'Raspberry Pi connected' stutter); per-line TX debug is opt-in.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
    [ScoreboardVolleyballChangeWinning.ino, scoreboard_link.py, test_link_protocol.py]
2026-10-05 Docs: phone display write-up, README section with screenshots, engineering log section 32, updated wiring diagram (Serial3, 5.1k/10k)
2026-10-05 Fix: hidden buttons really hide (fullscreen on iOS); Pi pulses must be real short pulses; clean LED boot
    - CSS: [hidden] now wins over display rules, so the fullscreen button disappears in Bluefy.
    - Sketch: a Pi score line that sits high (the Pi booting or shutting down pulls GPIO 0-8 high) is no longer counted as a point every 3 s; a pulse counts once, when it ends, if it was 15-400 ms long.
    - Sketch: the LED strip is blanked at the very start of setup, and the first frame is drawn with the slider's brightness and the real numbers instead of waiting for the first loop.
    [ScoreboardVolleyballChangeWinning.ino]
2026-10-05 Serial handshake: the vision engine says hello every second and the Mega ignores Pi score pulses without it
    The engine sends $C,PI,1*6B over the UART 0.3 s after each heartbeat toggle (sending at the toggle collided with the Mega's LED refresh, which has interrupts off for ~8 ms and ate the bytes). The Mega acts on Pi pulses only while the hello is < 4 s old, on top of the heartbeat and the pulse-width check. Also: loop-time and per-line pulse debug output.
    [PoseEstimationJT_Optimized.py, ScoreboardVolleyballChangeWinning.ino, test_link_protocol.py]
2026-10-06 Serial points (Pi -> Mega over the UART) and a relaxed T-pose tier
    Serial points: the vision engine's hello ($C,PI,2) and gestures ($C,PT,<L|R><P|C>,<id>, sent 3x, applied once)
    replace the GPIO pulse wires. The Mega gates Pi input on the hello, applies each id once, keeps a per-team 3 s
    cooldown and still honours a version-1 hello (old engine + wires). New pi/arduino_protocol.py; phone SCORE taps
    carry ids. Flashed and bench-tested on the real Mega (19/19 checks incl. 120 random gestures each applied once);
    see docs/plan-serial-points.md.
    T-pose: a second, relaxed tier accepts arms hanging up to 0.8 shoulder widths / 130 deg below level (never above
    level) and elbows >= 125 deg, but must b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
    [boot-config.txt]
2026-10-06 Detection strictness setting on the phone; no periodic images of an empty room
    Strictness: Settings > Detection (Stricter / Standard / Looser / Loosest) sends STRICT,0-3 over Bluetooth. The Pi
    stores it atomically in scoreboard_strictness.txt (survives a reboot) and reports it in bits 6-7 of the state flags;
    the vision engine re-reads it about once a second and uses the matching preset of the relaxed T-pose tier (how far
    arms may hang below level, elbow limit, hold length; Loosest wants 4 of 5 frames). Presets were measured on the
    Oct 5 frames: every rung keeps the 35 poses that scored before and the same 6 replayed confirmations; the loosest
    rung is where ordinary standing-with-arms-out sta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
    [PoseEstimationJT_Optimized.py, scoreboard_link.py, test_link_protocol.py, test_tpose_rules.py]
2026-10-06 Net line from the pole: optical locator keeps the left/right split on the real net
    The camera is aimed by hand and the near pole sat anywhere from 0.49 to 0.575 of the frame width in one indoor session,
    while the engine's split came from player positions clamped to 0.43-0.57 (a woman standing beside the net, on its left,
    was counted for the right-hand team). pi/net_pole.py finds the pole as a run of columns that is smooth along the
    vertical with a strong vertical edge on each side, voted by four row bands; NetPoleTracker locks after 3 consecutive
    agreeing readings (0.40-0.62), holds the lock when the pole is hidden, relocks after a re-aim, and does nothing when no
    pole is in view. NetCenterC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
2026-10-06 Detection strictness: re-space the presets (Loosest needs ~45 deg from the side), same 3-of-4 hold for all
    The first Loosest accepted arms only ~30 deg away from the side of the body and scored people just standing with their
    arms away from their sides (7 ordinary-play sightings of 1,696). New ladder, by arm angle away from the side: Stricter ~60,
    Standard ~55 (unchanged, what was field-tested), Looser ~50, Loosest ~45 deg (below_k / spine max / elbow min: 0.65/125/130,
    0.80/130/125, 0.90/130/120, 1.00/135/115). Measured on the Oct 5 frames: all four keep the 35 poses that scored before and
    the same 6 replayed confirmations, none lets an ordinary-play sighting through, and the drooping T-pos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
    [PoseEstimationJT_Optimized.py, test_tpose_rules.py]
